dhad4g/Lexington/docs/ece3700/PS2.md

# PS/2 Keyboard Peripheral

This module connects the PS/2 controller submodule to the AXI4-Lite data bus. It
maintains the current state of the keyboard and responds to requests from the
processor.

## Ports

### Parameters

- **`DATA_WIDTH = 32`** AXI4-Lite data width

### Inputs

### Outputs

- **`axi_s`** AXI4-Lite subordinate interface

## Behavior
