dhad4g/Lexington/docs/template.tex

\PassOptionsToPackage{unicode=true$for(hyperrefoptions)$,$hyperrefoptions$$endfor$}{hyperref} % options for packages loaded elsewhere
\PassOptionsToPackage{hyphens}{url}
$if(colorlinks)$
\PassOptionsToPackage{dvipsnames,svgnames*,x11names*}{xcolor}
$endif$$if(dir)$$if(latex-dir-rtl)$
\PassOptionsToPackage{RTLdocument}{bidi}
$endif$$endif$%
\documentclass[$if(fontsize)$$fontsize$,$endif$$if(lang)$$babel-lang$,$endif$$if(papersize)$$papersize$paper,$endif$$if(beamer)$ignorenonframetext,$if(handout)$handout,$endif$$if(aspectratio)$aspectratio=$aspectratio$,$endif$$endif$$for(classoption)$$classoption$$sep$,$endfor$]{$documentclass$}
%--------------------------------------------------
% My changes
\usepackage{rotating}
%--------------------------------------------------
$if(beamer)$
$if(background-image)$
\usebackgroundtemplate{%
%
}
$endif$
\usepackage{pgfpages}
\setbeamertemplate{caption}[numbered]
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
$highlighting-macros$
$endif$
$if(tables)$
\usepackage{longtable,booktabs}
$if(beamer)$
\usepackage{caption}
% These lines are needed to make table captions work with longtable:
\makeatletter
\def\fnum@table{\tablename~\thetable}
\makeatother
$else$
% Fix footnotes in tables (requires footnote package)
\IfFileExists{footnote.sty}{\usepackage{footnote}\makesavenoteenv{longtable}}{}
$endif$
$endif$
%--------------------------------------------------
% My changes
\usepackage{graphicx,grffile}
%--------------------------------------------------
$if(graphics)$
% \usepackage{graphicx,grffile}
\makeatletter
\def\maxwidth{\ifdim\Gin@nat@width>\linewidth\linewidth\else\Gin@nat@width\fi}
\def\maxheight{\ifdim\Gin@nat@height>\textheight\textheight\else\Gin@nat@height\fi}
\makeatother
% Scale images if necessary, so that they will not overflow the page
% margins by default, and it is still possible to overwrite the defaults
% using explicit options in \includegraphics[width, height, ...]{}
\setkeys{Gin}{width=\maxwidth,height=\maxheight,keepaspectratio}
$endif$
$if(links-as-notes)$
% Make links footnotes instead of hotlinks:
\DeclareRobustCommand{\href}[2]{#2\footnote{\url{#1}}}
$endif$
$if(strikeout)$
\usepackage[normalem]{ulem}
% avoid problems with \sout in headers with hyperref:
\pdfstringdefDisableCommands{\renewcommand{\sout}{}}
$endif$
\setlength{\emergencystretch}{3em}  % prevent overfull lines
\providecommand{\tightlist}{%
  \setlength{\itemsep}{0pt}\setlength{\parskip}{0pt}}
$if(numbersections)$
\setcounter{secnumdepth}{$if(secnumdepth)$$secnumdepth$$else$5$endif$}
$else$
\setcounter{secnumdepth}{0}
$endif$
$if(beamer)$
$else$
$if(subparagraph)$
$else$
% Redefines (sub)paragraphs to behave more like sections
\ifx\paragraph\undefined\else
\let\oldparagraph\paragraph
\renewcommand{\paragraph}[1]{\oldparagraph{#1}\mbox{}}
\fi
\ifx\subparagraph\undefined\else
\let\oldsubparagraph\subparagraph
\renewcommand{\subparagraph}[1]{\oldsubparagraph{#1}\mbox{}}
\fi
$endif$
$endif$
$if(pagestyle)$
\pagestyle{$pagestyle$}
$endif$

% set default figure placement to htbp
\makeatletter
\def\fps@figure{htbp}
\makeatother

$for(header-includes)$
$header-includes$
$endfor$
$if(lang)$
\ifnum 0\ifxetex 1\fi\ifluatex 1\fi=0 % if pdftex
  \usepackage[shorthands=off,$for(babel-otherlangs)$$babel-otherlangs$,$endfor$main=$babel-lang$]{babel}
$if(babel-newcommands)$
  $babel-newcommands$
$endif$
\else
  % load polyglossia as late as possible as it *could* call bidi if RTL lang (e.g. Hebrew or Arabic)
  \usepackage{polyglossia}
  \setmainlanguage[$polyglossia-lang.options$]{$polyglossia-lang.name$}
$for(polyglossia-otherlangs)$
  \setotherlanguage[$polyglossia-otherlangs.options$]{$polyglossia-otherlangs.name$}
$endfor$
\fi
$endif$
$if(dir)$
\ifxetex
  % load bidi as late as possible as it modifies e.g. graphicx
  \usepackage{bidi}
\fi
\ifnum 0\ifxetex 1\fi\ifluatex 1\fi=0 % if pdftex
  \TeXXeTstate=1
  \newcommand{\RL}[1]{\beginR #1\endR}
  \newcommand{\LR}[1]{\beginL #1\endL}
  \newenvironment{RTL}{\beginR}{\endR}
  \newenvironment{LTR}{\beginL}{\endL}
\fi
$endif$
$if(natbib)$
\usepackage[$natbiboptions$]{natbib}
\bibliographystyle{$if(biblio-style)$$biblio-style$$else$plainnat$endif$}
$endif$
$if(biblatex)$
\usepackage[$if(biblio-style)$style=$biblio-style$,$endif$$for(biblatexoptions)$$biblatexoptions$$sep$,$endfor$]{biblatex}
$for(bibliography)$
\addbibresource{$bibliography$}
$endfor$
$endif$

% $if(title)$
% \title{$title$$if(thanks)$\thanks{$thanks$}$endif$}
% $endif$
% $if(subtitle)$
% \providecommand{\subtitle}[1]{}
% \subtitle{$subtitle$}
% $endif$
% $if(author)$
% \author{$for(author)$$author$$sep$ \and $endfor$}
% $endif$
% $if(institute)$
% \providecommand{\institute}[1]{}
% \institute{$for(institute)$$institute$$sep$ \and $endfor$}
% $endif$
% \date{$date$}
% $if(beamer)$
% $if(titlegraphic)$
% \titlegraphic{\includegraphics{$titlegraphic$}}
% $endif$
% $if(logo)$
% \logo{\includegraphics{$logo$}}
% $endif$
% $endif$

\begin{document}

% $if(title)$
% $if(beamer)$
% \frame{\titlepage}
% $else$
% \maketitle
% $endif$
% $if(abstract)$
% \begin{abstract}
% $abstract$
% \end{abstract}
% $endif$
%
% % My changes
% \clearpage
% %--------------------------------------------------
% $endif$

%--------------------------------------------------
% Custom title page
$if(title)$
\begin{center}
    \thispagestyle{empty}
    $if(institute)$
        {\LARGE $institute$} \\
        \vspace{0.5cm}
    $endif$
    $if(logo)$
         \\
    $endif$
    \vspace{5cm}
    \textbf{\LARGE GPro1 Lexington}\\[\baselineskip] % Main title
    $if(subtitle)$
        {\LARGE \textit{$subtitle$}} \\ % Subtitle
    $endif$
    \vspace{3cm}
    $if(author)$
        {\large Authors:} \\
        \vspace{0.5cm}
        $for(author)$
            {\large \textit{$author$}} \\
        $endfor$
    $endif$
    \vfill
    This document is a part of an open source project which is freely available
    for private and comercial use under the GPLv3 license. For additional information
    or better rendering of large tables, refer to
    \href{https://github.com/GProCpu/Lexington}{https://github.com/GProCpu/Lexington}.
    \\ \vspace{0.5cm}
    Copyright (C) \the\year{}  $institute$ \\
    \vspace{1cm}
    \today
\end{center}
\clearpage
$endif$
%--------------------------------------------------

$for(include-before)$
$include-before$
$endfor$

$if(toc)$
$if(toc-title)$
\renewcommand*\contentsname{$toc-title$}
$endif$
$if(beamer)$
\begin{frame}
$if(toc-title)$
\frametitle{$toc-title$}
$endif$
\tableofcontents[hideallsubsections]
\end{frame}
$else$
{
$if(colorlinks)$
\hypersetup{linkcolor=$if(toccolor)$$toccolor$$else$$endif$}
$endif$
\setcounter{tocdepth}{$toc-depth$}
\tableofcontents
}
$endif$
%--------------------------------------------------
% My changes
\clearpage
%--------------------------------------------------
$endif$

$if(lot)$
\listoftables
%--------------------------------------------------
% My changes
\clearpage
%--------------------------------------------------
$endif$
$if(lof)$
\listoffigures
%--------------------------------------------------
% My changes
\clearpage
%--------------------------------------------------
$endif$

$body$

$if(natbib)$
$if(bibliography)$
$if(biblio-title)$
$if(book-class)$
\renewcommand\bibname{$biblio-title$}
$else$
\renewcommand\refname{$biblio-title$}
$endif$
$endif$
$if(beamer)$
\begin{frame}[allowframebreaks]{$biblio-title$}
\bibliographytrue
$endif$
\bibliography{$for(bibliography)$$bibliography$$sep$,$endfor$}
$if(beamer)$
\end{frame}
$endif$

$endif$
$endif$
$if(biblatex)$
$if(beamer)$
\begin{frame}[allowframebreaks]{$biblio-title$}
\bibliographytrue
\printbibliography[heading=none]
\end{frame}
$else$
\printbibliography$if(biblio-title)$[title=$biblio-title$]$endif$
$endif$

$endif$
$for(include-after)$
$include-after$

$endfor$
\end{document}
