dhad4g/Lexington/docs/RegisterFile.md

# Register File

This is the main integer register file for the CPU core.
It features asynchronous reads and synchronous writes.

## Ports

#### Parameters

- **`XLEN = 32`** data width
- **`ADDR_WIDTH = 5`** = determines the number of registers (from rv32)

#### Inputs

- **`rs1_en`** enable for read port 1
- **`rs1_addr[ADDR_WIDTH-1:0]`** address for read port 1
- **`rs2_en`** enable for read port 2
- **`rs2_addr[ADDR_WIDTH-1:0]`** address for read port 2
- **`dest_en`** enable for write port
- **`dest_addr[ADDR_WIDTH-1:0]`** address for write port
- **`dest_data[XLEN-1:0]`** data in for write port

#### Outputs

- **`rs1_data[XLEN-1:0]`** data out for read port 1
- **`rs2_data[XLEN-1:0]`** data out for read port 2

## Behavior

This module behaves as a register file with two read ports and one write port.
Reads are performed asynchronously.
Writes are performed synchronously.
Additionally, reading from address zero always returns zeros.
Writing to address zero has no effect.

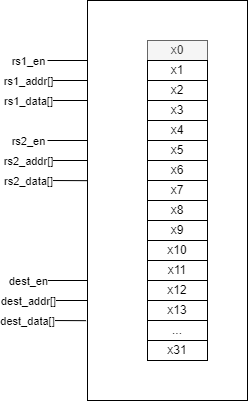
[picture p5: docs/figures/RegisterFile.drawio.png]
Block Diagram
 \
**Figure 1.** Register File block diagram
