dhad4g/Lexington/docs/ece3700/ps2_controller_state_diagram.jpeg

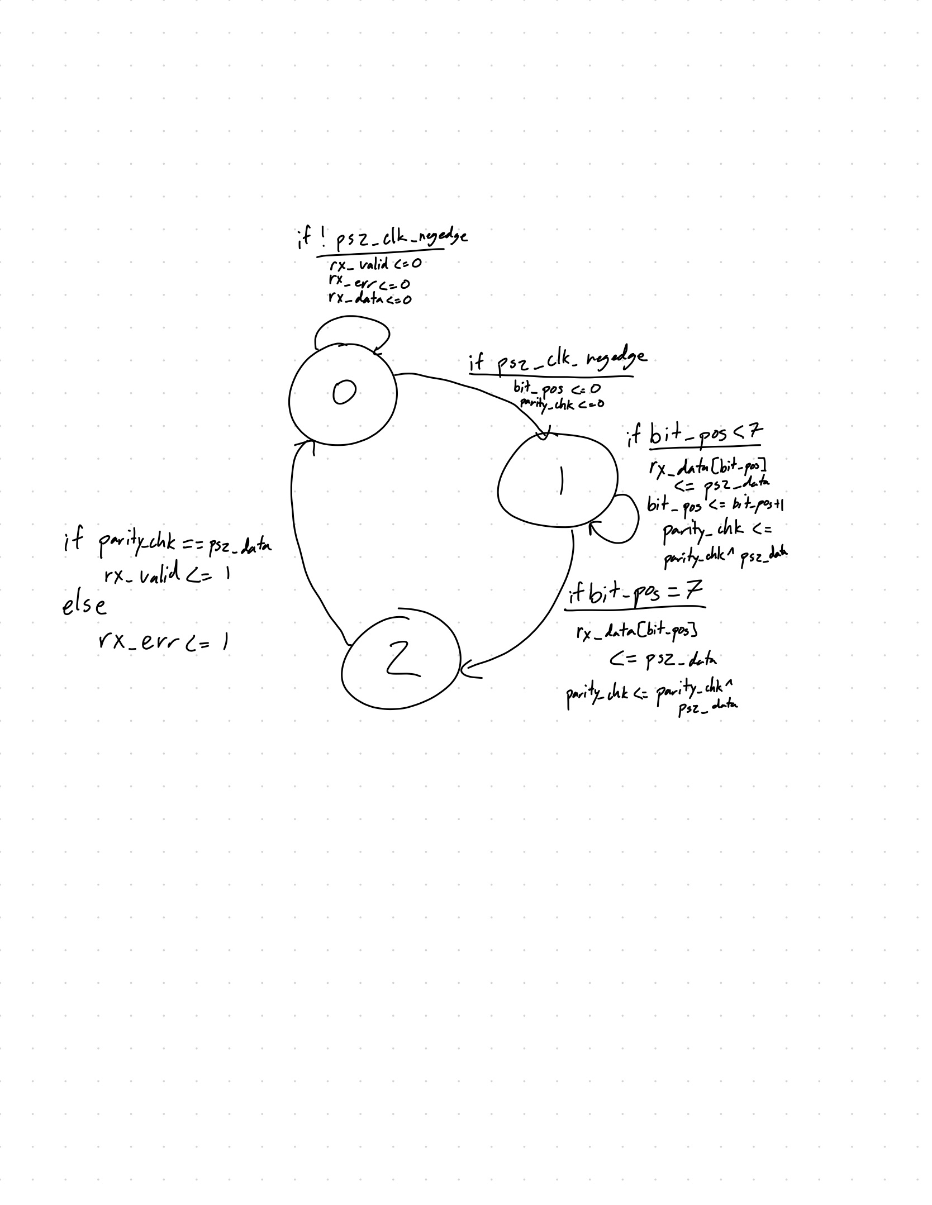
docs/ece3700/ps2_controller_state_diagram.jpeg
