dhad4g/Lexington/docs/figures/GerberPrototypingBulb.png

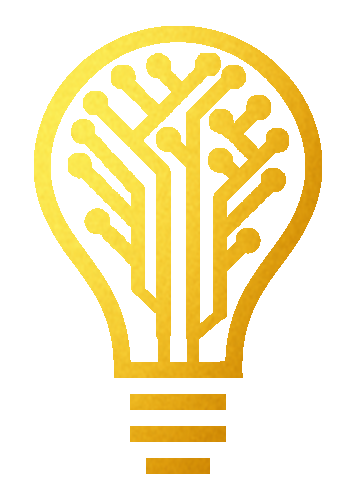
docs/figures/GerberPrototypingBulb.png
