dhad4g/Lexington/docs/figures/InstructionFormats.drawio.png

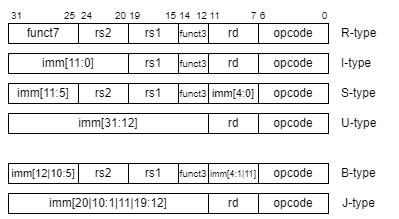
docs/figures/InstructionFormats.drawio.png
