dhad4g/Lexington/docs/figures/Instructions.drawio.png

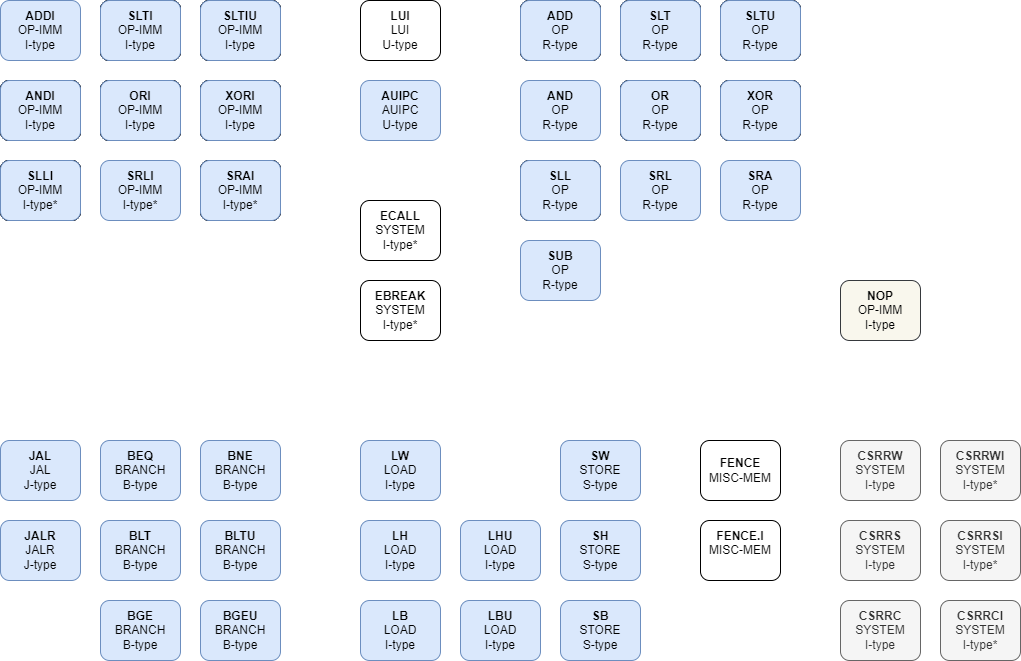
docs/figures/Instructions.drawio.png
