dhad4g/Lexington/rtl/lexington_soc.sv

//depend core.sv
//depend core/*.sv
//depend mem/rom.sv
//depend mem/ram.sv
//depend axi4_lite_manager.sv
//depend axi4_lite_crossbar.sv
//depend peripheral/gpio.sv
`timescale 1ns/1ps

`include "rv32.sv"
`include "lexington.sv"
`include "axi4_lite.sv"
import lexington::*;


module lexington_soc #(
        parameter CLK_PERIOD    = DEFAULT_CLK_PERIOD    // system clock period in ns
    ) (
        input  logic clk,                       // system clock
        input  logic rst_n,                     // reset signal (active-high)

        inout  logic [15:0] gpioa,
        inout  logic [15:0] gpiob,
        inout  logic [15:0] gpioc
    );

    // Core Parameters
    localparam ROM_ADDR_WIDTH       = DEFAULT_ROM_ADDR_WIDTH;       // ROM address width (word-addressable, default 4kB)
    localparam RAM_ADDR_WIDTH       = DEFAULT_RAM_ADDR_WIDTH;       // RAM address width (word-addressable, default 4kB)
    localparam AXI_ADDR_WIDTH       = DEFAULT_AXI_ADDR_WIDTH;       // AXI bus address space width (byte-addressable)
    localparam ROM_BASE_ADDR        = DEFAULT_ROM_BASE_ADDR;        // ROM base address (must be aligned to ROM size)
    localparam RAM_BASE_ADDR        = DEFAULT_RAM_BASE_ADDR;        // RAM base address (must be aligned to RAM size)
    localparam MTIME_BASE_ADDR      = DEFAULT_MTIME_BASE_ADDR;      // machine timer base address (see [CSR](./CSR.md))
    localparam AXI_BASE_ADDR        = DEFAULT_AXI_BASE_ADDR;        // AXI bus address space base (must be aligned to AXI address space)
    localparam AXI_TIMEOUT          = DEFAULT_AXI_TIMEOUT;          // AXI bus timeout in cycles
    localparam HART_ID              = 0;                            // hardware thread id (see mhartid CSR)
    localparam RESET_ADDR           = DEFAULT_RESET_ADDR;           // program counter reset/boot address
    localparam USE_CSR              = 1;                            // enable generation of the CSR module
    localparam USE_TRAP             = 1;                            // enable generation of the Trap Unit (requires CSR)
    localparam USE_MTIME            = 0;                            // enable generation of machine timer address space
    localparam USE_AXI              = 1;                            // enable generation of AXI address space


    ////////////////////////////////////////////////////////////
    ////////////////////////////////////////////////////////////
    // BEGIN: Internal Wires
    ////////////////////////////////////////////////////////////
    // ROM ports
    logic rom_rd_en1;                                   // IBus
    logic [ROM_ADDR_WIDTH-1:0] rom_addr1;               // IBus
    rv32::word rom_rd_data1;                            // IBus
    logic rom_rd_en2;                                   // DBus
    logic [ROM_ADDR_WIDTH-1:0] rom_addr2;               // DBus
    rv32::word rom_rd_data2;                            // DBus
    // RAM ports
    logic ram_rd_en;                                    // DBus
    logic ram_wr_en;                                    // DBus
    logic [RAM_ADDR_WIDTH-1:0] ram_addr;                // DBus
    rv32::word ram_rd_data;                             // DBus
    // AXI Manager ports
    logic axi_rd_en;                                    // DBus
    logic axi_wr_en;                                    // DBus
    logic [AXI_ADDR_WIDTH-1:0] axi_addr;                // DBus
    rv32::word axi_rd_data;                             // DBus
    logic axi_access_fault;                             // DBus
    logic axi_busy;                                     // DBus
    rv32::word wr_data;                                 // shared write data
    logic [(rv32::XLEN/8)-1:0] wr_strobe;               // shared write strobe
    // Interrupt flags
    logic gpioa_int_0;                                  // GPIOA interrupt 0
    logic gpioa_int_1;                                  // GPIOA interrupt 1
    logic gpiob_int_0;                                  // GPIOA interrupt 0
    logic gpiob_int_1;                                  // GPIOA interrupt 1
    logic gpioc_int_0;                                  // GPIOA interrupt 0
    logic gpioc_int_1;                                  // GPIOA interrupt 1
    logic uart0_rx_int;                                 // UART0 RX interrupt
    logic uart0_tx_int;                                 // UART0 TX interrupt
    logic timer0_int;                                   // timer0 interrupt
    logic timer1_int;                                   // timer1 interrupt
    // AXI bus
    axi4_lite #(.WIDTH(rv32::XLEN), .ADDR_WIDTH(AXI_ADDR_WIDTH)) axi_m();
    axi4_lite #(.WIDTH(rv32::XLEN), .ADDR_WIDTH(GPIO_ADDR_WIDTH)) axi_gpioa();
    axi4_lite #(.WIDTH(rv32::XLEN), .ADDR_WIDTH(GPIO_ADDR_WIDTH)) axi_gpiob();
    axi4_lite #(.WIDTH(rv32::XLEN), .ADDR_WIDTH(GPIO_ADDR_WIDTH)) axi_gpioc();
    ////////////////////////////////////////////////////////////
    // END: Internal Wires
    ////////////////////////////////////////////////////////////
    ////////////////////////////////////////////////////////////




    ////////////////////////////////////////////////////////////
    ////////////////////////////////////////////////////////////
    // BEGIN: Core Instantiation
    ////////////////////////////////////////////////////////////
    core #(
        .CLK_PERIOD(CLK_PERIOD),
        .ROM_ADDR_WIDTH(ROM_ADDR_WIDTH),
        .RAM_ADDR_WIDTH(RAM_ADDR_WIDTH),
        .AXI_ADDR_WIDTH(AXI_ADDR_WIDTH),
        .ROM_BASE_ADDR(ROM_BASE_ADDR),
        .RAM_BASE_ADDR(RAM_BASE_ADDR),
        .MTIME_BASE_ADDR(MTIME_BASE_ADDR),
        .AXI_BASE_ADDR(AXI_BASE_ADDR),
        .HART_ID(HART_ID),
        .RESET_ADDR(RESET_ADDR),
        .USE_CSR(USE_CSR),
        .USE_TRAP(USE_TRAP),
        .USE_MTIME(USE_MTIME),
        .USE_AXI(USE_AXI)
    ) core0 (
        .clk,
        .rst_n,
        .rom_rd_en1,
        .rom_addr1,
        .rom_rd_data1,
        .rom_rd_en2,
        .rom_addr2,
        .rom_rd_data2,
        .ram_rd_en,
        .ram_wr_en,
        .ram_addr,
        .ram_rd_data,
        .axi_rd_en,
        .axi_wr_en,
        .axi_addr,
        .axi_rd_data,
        .axi_access_fault,
        .axi_busy,
        .wr_data,
        .wr_strobe,
        .gpioa_int_0,
        .gpioa_int_1,
        .gpiob_int_0,
        .gpiob_int_1,
        .gpioc_int_0,
        .gpioc_int_1,
        .uart0_rx_int,
        .uart0_tx_int,
        .timer0_int,
        .timer1_int
    );
    ////////////////////////////////////////////////////////////
    // END: Core Instantiation
    ////////////////////////////////////////////////////////////
    ////////////////////////////////////////////////////////////




    ////////////////////////////////////////////////////////////
    ////////////////////////////////////////////////////////////
    // BEGIN: ROM & RAM Instantiation
    ////////////////////////////////////////////////////////////
    rom #(
        .ADDR_WIDTH(ROM_ADDR_WIDTH)
    ) rom0 (
        .rd_en1(rom_rd_en1),
        .addr1(rom_addr1),
        .rd_data1(rom_rd_data1),
        .rd_en2(rom_rd_en2),
        .addr2(rom_addr2),
        .rd_data2(rom_rd_data2)
    );

    ram #(
        .ADDR_WIDTH(RAM_ADDR_WIDTH),
        .DUMP_MEM(0)
    ) ram0 (
        .clk,
        .rd_en(ram_rd_en),
        .wr_en(ram_wr_en),
        .addr(ram_addr),
        .wr_data,
        .wr_strobe,
        .rd_data(ram_rd_data)
    );
    ////////////////////////////////////////////////////////////
    // END: ROM & RAM Instantiation
    ////////////////////////////////////////////////////////////
    ////////////////////////////////////////////////////////////




    ////////////////////////////////////////////////////////////
    ////////////////////////////////////////////////////////////
    // BEGIN: AXI Manager & Crossbar Instantiation
    ////////////////////////////////////////////////////////////
    axi4_lite_manager #(
        .ADDR_WIDTH(AXI_ADDR_WIDTH),
        .TIMEOUT(AXI_TIMEOUT)
    ) core0_axi (
        .clk,
        .rst_n,
        .rd_en(axi_rd_en),
        .wr_en(axi_wr_en),
        .addr(axi_addr),
        .wr_data,
        .wr_strobe,
        .rd_data(axi_rd_data),
        .access_fault(axi_access_fault),
        .busy(axi_busy),
        .axi_m(axi_m.manager)
    );
    axi4_lite_crossbar #(
        .WIDTH(rv32::XLEN),
        .ADDR_WIDTH(AXI_ADDR_WIDTH),
        .COUNT(3),
        .S_ADDR_WIDTH({GPIO_ADDR_WIDTH, GPIO_ADDR_WIDTH, GPIO_ADDR_WIDTH}),
        .S_BASE_ADDR({GPIOA_BASE_ADDR, GPIOB_BASE_ADDR, GPIOC_BASE_ADDR})
    ) crossbar (
        .axi_m,
        .axi_sx({
            axi_gpioa,
            axi_gpiob,
            axi_gpioc
        })
    );
    ////////////////////////////////////////////////////////////
    // END: AXI Manager & Crossbar Instantiation
    ////////////////////////////////////////////////////////////
    ////////////////////////////////////////////////////////////




    ////////////////////////////////////////////////////////////
    ////////////////////////////////////////////////////////////
    // BEGIN: Peripheral Instantiations
    ////////////////////////////////////////////////////////////
    gpio #(
        .WIDTH(rv32::XLEN),
        .PIN_COUNT(16)
    ) gpioa_inst (
        .io_pins(gpioa),
        .int0(gpioa_int_0),
        .int1(gpioa_int_1),
        .axi(axi_gpioa)
    );
    gpio #(
        .WIDTH(rv32::XLEN),
        .PIN_COUNT(16)
    ) gpiob_inst (
        .io_pins(gpiob),
        .int0(gpiob_int_0),
        .int1(gpiob_int_1),
        .axi(axi_gpiob)
    );
    gpio #(
        .WIDTH(rv32::XLEN),
        .PIN_COUNT(16)
    ) gpioc_inst (
        .io_pins(gpioc),
        .int0(gpioc_int_0),
        .int1(gpioc_int_1),
        .axi(axi_gpioc)
    );
    assign uart0_rx_int = 0;
    assign uart0_tx_int = 0;
    assign timer0_int = 0;
    assign timer1_int = 0;
    ////////////////////////////////////////////////////////////
    // END: Peripheral Instantiations
    ////////////////////////////////////////////////////////////
    ////////////////////////////////////////////////////////////


endmodule
