dhad4g/Lexington/(commit log)

2023-09-08 Begin UART development
2023-10-06 Update README to 3-stage design
2023-10-23 Simulation passing
    Missing user-mode test
    [core.sv, core_TB.sv, csr.sv, dbus.sv, decoder.sv, fetch.sv, pc.sv, regfile.sv]
2023-10-26 Fix incorrect CSR and GPR writes during exceptions
    [core.sv, csr.sv, lexington.sv, lsu.sv, mtime.sv, soc.sv, top.sv]
2023-12-08 Foundation Flow
2024-04-22 Created implementation of PS/2 Controller per state diagram created previously (edited to correct parity bit)
    [ps2_controller.sv]
2024-04-24 Continued work on testing. 1 pass, 1 fail.
    [ps2_controller.sv, ps2_controller_TB.sv]
2024-04-24 Worked on testbench more. There is something wrong with how I am checking the parity bit. Failed 4 out of 4.
    [ps2_controller.sv, ps2_controller_TB.sv]
